YixiaoHong/PID-controlled-propeller-pendulum/README.md

# PID-controlled-propeller-pendulum

## video of the project: 
https://youtu.be/_mAuMV6Je3g

## Breif Introduction of the project
A group project from the course "Control Systems I". Implemented PID to control the angle of the propeller pendulum which can hold a specific angle or tracks a sinusoidal wave with resistance to disturbances. 

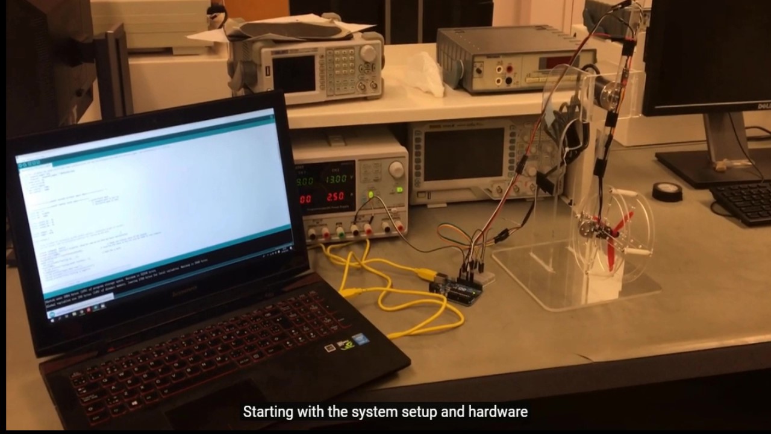
[picture p1: img/setup.jpg]


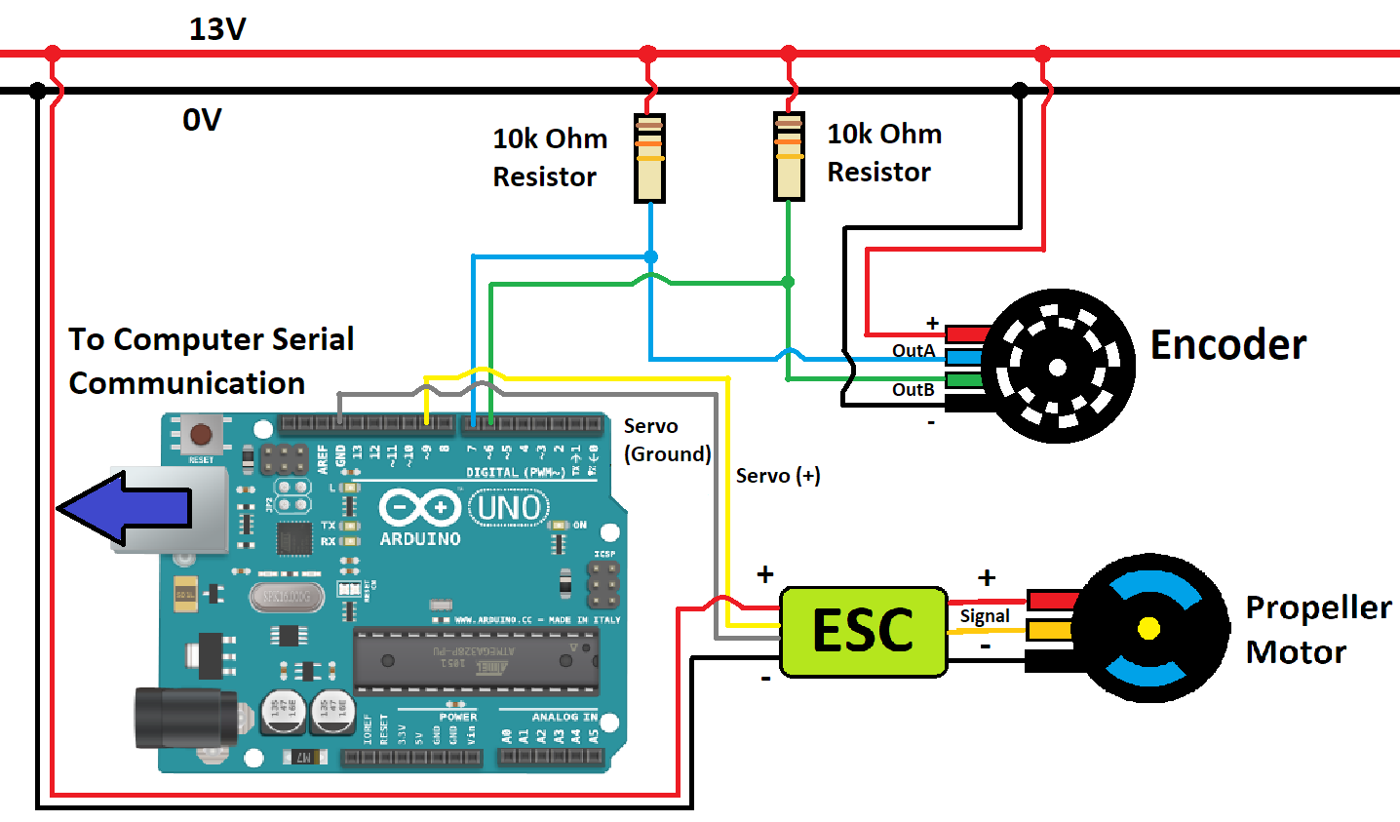
[picture p2: img/Wire_Connection.png]
